madelineanunn/buck_converter_12v_5v/buck_converter_12v_5v.asc

C1: cap; 22µ; Rser=68m
D1: schottky; MBRS340
L1: ind; 47µ; Rser=50m
M1: nmos; Si4410DY
R1: res; {Rload}
V1: voltage; 12
V2: voltage; PULSE(0 10 0 10n 10n {D/fsw} {1/fsw})
Named nets: 0, in, out
.param fsw=200k D=0.43 Rload=5
.step param Rload list 50 20 10 6.667 5
.tran 0 6m 5m 10n
.meas TRAN Pin AVG -V(in)*I(V1)
.meas TRAN Pout AVG V(out)*I(R1)
.meas TRAN eff PARAM Pout/Pin
.meas TRAN Vout AVG V(out)
.meas TRAN Vripple PP V(out)
.meas TRAN ILpp PP I(L1)
