madelineanunn/buck_converter_12v_5v/results_log.png

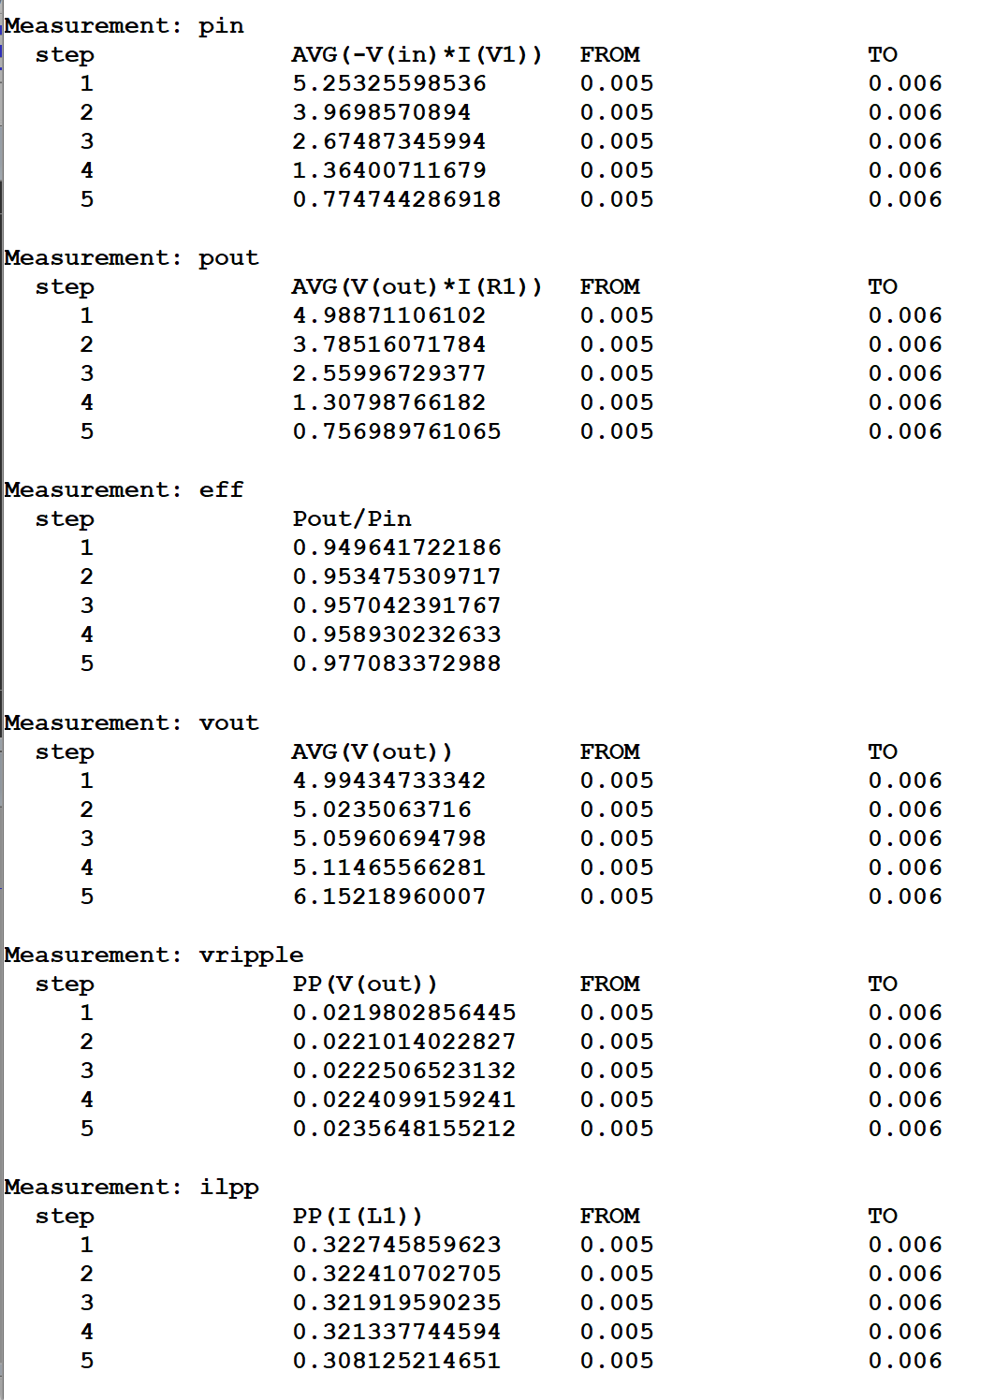
results_log.png
