madelineanunn/buck_converter_12v_5v/(commit log)

2026-10-28 Fix formatting issues in README.md
    Corrected formatting and capitalization in equations and schematic reference.
2026-10-28 Fix schematic image filename in README
    Corrected the image filename for the schematic in the README.
